AngelRam320/Rosetta_Base_v0.1/Core/Src/main.c

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
/* Includes ------------------------------------------------------------------*/
#include "main.h"
#include "fatfs.h"
#include "i2c.h"
#include "rtc.h"
#include "spi.h"
#include "tim.h"
#include "gpio.h"

/* USER CODE BEGIN Includes */
#include "rosetta.h"
#include "sdio.h"
/* USER CODE END Includes */


void SystemClock_Config(void);
/**
  * @brief  The application entry point.
  * @retval int
  */
int main(void)
{

  /* MCU Configuration--------------------------------------------------------*/

  /* Reset of all peripherals, Initializes the Flash interface and the Systick. */
  HAL_Init();

  /* Configure the system clock */
  SystemClock_Config();

  /* Initialize all configured peripherals */
  MX_GPIO_Init();
  MX_I2C1_Init();
  MX_RTC_Init();
  MX_SPI3_Init();
  MX_TIM12_Init();
  MX_FATFS_Init();
  /* USER CODE BEGIN 2 */
  RosettaHandles rosetta_hw =
  {
    .i2c_internal   = &hi2c1,
    .spi_flash      = &hspi3,
    .rtc            = &hrtc,
    .sd             = &hsd,
    .buzzer_tim     = &htim12,
    .buzzer_channel = TIM_CHANNEL_1
  };

  Rosetta_Init(&rosetta_hw);
  /* USER CODE END 2 */

  /* Infinite loop */
  /* USER CODE BEGIN WHILE */
  while (1)
  {
    Rosetta_Update();
    /* USER CODE END WHILE */

    /* USER CODE BEGIN 3 */
  }
  /* USER CODE END 3 */
}

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
