AngelRam320/Rosetta_Base_v0.1/Rosetta_Base.ioc

Mcu.UserName=STM32F446RETx
PA13.Signal=SYS_JTMS-SWDIO
PA14.Signal=SYS_JTCK-SWCLK
PA15.GPIO_Label=USER_LED
PA15.Signal=GPIO_Output
PB0.Signal=SDIO_D1
PB1.Signal=SDIO_D2
PB14.Signal=S_TIM12_CH1
PB15.GPIO_Label=USER_KEY
PB15.Signal=GPIO_Input
PB2.Signal=SDIO_CK
PB3.Signal=SPI3_SCK
PB4.Signal=SPI3_MISO
PB5.GPIO_Label=FLASH_CS
PB5.Signal=GPIO_Output
PB6.Signal=I2C1_SCL
PB7.Signal=I2C1_SDA
PC1.Signal=SPI3_MOSI
PC11.Signal=SDIO_D3
PC14-OSC32_IN.Signal=RCC_OSC32_IN
PC15-OSC32_OUT.Signal=RCC_OSC32_OUT
PC8.Signal=SDIO_D0
PD2.Signal=SDIO_CMD
PH0-OSC_IN.Signal=RCC_OSC_IN
PH1-OSC_OUT.Signal=RCC_OSC_OUT
