AngelRam320/Rosetta_Base_v0.1/Core/Inc/main.h

#define USER_KEY_Pin GPIO_PIN_15
#define USER_KEY_GPIO_Port GPIOB
#define USER_LED_Pin GPIO_PIN_15
#define USER_LED_GPIO_Port GPIOA
#define FLASH_CS_Pin GPIO_PIN_5
#define FLASH_CS_GPIO_Port GPIOB
