AngelRam320/Rosetta_Base_v0.1/Rosetta/Inc/rosetta_logo.h

#ifndef ROSETTA_LOGO_H
#define ROSETTA_LOGO_H
#include <stdint.h>
#define ROSETTA_LOGO_WIDTH 128
#define ROSETTA_LOGO_HEIGHT 64
static const uint8_t rosetta_logo_128x64[1024] = {
    0xFF, 0xFF, 0xFF, 0xFF, 0xFF, 0xFF, 0xFF, 0xFF, 0xFF, 0xFF, 0xFF, 0xFF, 0xFF, 0xFF, 0xFF, 0x01,
    0x01, 0xF1, 0xF1, 0xF1, 0xF1, 0xF1, 0xF1, 0xF1, 0xF1, 0xF3, 0x03, 0x07, 0xFF, 0xFF, 0x1F, 0x07,
    0xC3, 0xF3, 0xF3, 0xF1, 0xF1, 0xF1, 0xF1, 0xF1, 0xF3, 0xF3, 0xC3, 0x07, 0x1F, 0xFF, 0xFF, 0x87,
    0x03, 0x33, 0x71, 0x71, 0x71, 0x71, 0x71, 0x71, 0x71, 0x71, 0x71, 0xFB, 0xFF, 0xFF, 0x03, 0x01,
    0xF1, 0xF1, 0x71, 0x71, 0x71, 0x71, 0x71, 0x71, 0x71, 0xFF, 0xFF, 0xF1, 0xF1, 0xF1, 0xF1, 0x01,
    0x01, 0x01, 0xF1, 0xF1, 0xF1, 0xF1, 0xFF, 0xFF, 0xF1, 0xF1, 0xF1, 0xF1, 0x01, 0x01, 0x01, 0xF1,
    0xF1, 0xF1, 0xF1, 0xFF, 0xFF, 0xFF, 0x3F, 0x0F, 0x87, 0xE1, 0xE1, 0x87, 0x1F, 0x3F, 0xFF, 0xFF,
    0xFF, 0xFF, 0xFF, 0xFF, 0xFF, 0xFF, 0xFF, 0xFF, 0xFF, 0xFF, 0xFF, 0xFF, 0xFF, 0xFF, 0xFF, 0xFF,
    0xFF, 0xFF, 0xFF, 0xFF, 0xFF, 0xFF, 0xFF, 0xFF, 0xFF, 0xFF, 0xFF, 0xFF, 0xFF, 0xFF, 0xFF, 0xC0,
    0xC0, 0xFF, 0xFD, 0xF9, 0xFD, 0xFD, 0xFD, 0xF9, 0xF0, 0xE0, 0xC4, 0xCE, 0xDF, 0xFF, 0xFC, 0xF0,
    0xE3, 0xC7, 0xCF, 0xCF, 0xCF, 0xCF, 0xCF, 0xCF, 0xCF, 0xC7, 0xE3, 0xF0, 0xF8, 0xFF, 0xFF, 0xCF,
    0xCF, 0xCF, 0xCF, 0xCF, 0xCF, 0xCF, 0xCF, 0xCF, 0xCE, 0xC6, 0xC0, 0xE0, 0xFF, 0xFF, 0xC0, 0xC0,
    0xC7, 0xCF, 0xCF, 0xCF, 0xCF, 0xCF, 0xCF, 0xCF, 0xCF, 0xFF, 0xFF, 0xFF, 0xFF, 0xFF, 0xFF, 0xC0,
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
    0xFF, 0xFF, 0xFF, 0xFF, 0xFF, 0xFF, 0xFF, 0xFF, 0xFF, 0xFF, 0xFF, 0xFF, 0xFF, 0xFF, 0xFF, 0xFF,
    0xFF, 0xFF, 0xFF, 0xFF, 0xFF, 0xFF, 0xFF, 0xFF, 0xFF, 0xFF, 0xFF, 0xFF, 0xFF, 0xFF, 0xFF, 0xFF,
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
};
#endif
