AngelRam320/Rosetta_Base_v0.1/Rosetta/Inc/rosetta_font5x7.h

#ifndef ROSETTA_FONT5X7_H
#define ROSETTA_FONT5X7_H
#include <stdint.h>
#define ROSETTA_FONT_FIRST 32
#define ROSETTA_FONT_LAST 95
static const uint8_t rosetta_font5x7[64][5] = {
    {0x00, 0x00, 0x00, 0x00, 0x00}, /* ' ' */
    {0x00, 0x00, 0x5F, 0x00, 0x00}, /* '!' */
    {0x00, 0x03, 0x00, 0x03, 0x00}, /* '"' */
    {0x12, 0x3F, 0x12, 0x3F, 0x12}, /* '#' */
    {0x24, 0x2A, 0x7F, 0x2A, 0x12}, /* '$' */
    {0x13, 0x0B, 0x34, 0x32, 0x01}, /* '%' */
    {0x36, 0x49, 0x55, 0x22, 0x50}, /* '&' */
    {0x00, 0x00, 0x03, 0x00, 0x00}, /* '\'' */
    {0x00, 0x1C, 0x22, 0x41, 0x00}, /* '(' */
    {0x00, 0x41, 0x22, 0x1C, 0x00}, /* ')' */
    {0x2A, 0x1C, 0x3E, 0x1C, 0x2A}, /* '*' */
    {0x08, 0x08, 0x3E, 0x08, 0x08}, /* '+' */
    {0x00, 0x40, 0x30, 0x00, 0x00}, /* ',' */
    {0x08, 0x08, 0x08, 0x08, 0x08}, /* '-' */
    {0x00, 0x00, 0x60, 0x60, 0x00}, /* '.' */
    {0x10, 0x08, 0x04, 0x02, 0x01}, /* '/' */
    {0x3E, 0x51, 0x49, 0x45, 0x3E}, /* '0' */
    {0x00, 0x42, 0x7F, 0x40, 0x00}, /* '1' */
    {0x42, 0x61, 0x51, 0x49, 0x46}, /* '2' */
    {0x41, 0x49, 0x49, 0x49, 0x36}, /* '3' */
    {0x18, 0x14, 0x12, 0x7F, 0x10}, /* '4' */
    {0x4F, 0x49, 0x49, 0x49, 0x31}, /* '5' */
    {0x3E, 0x49, 0x49, 0x49, 0x30}, /* '6' */
    {0x01, 0x71, 0x09, 0x05, 0x03}, /* '7' */
    {0x36, 0x49, 0x49, 0x49, 0x36}, /* '8' */
    {0x06, 0x49, 0x49, 0x49, 0x3E}, /* '9' */
    {0x00, 0x00, 0x36, 0x36, 0x00}, /* ':' */
    {0x00, 0x40, 0x36, 0x16, 0x00}, /* ';' */
    {0x08, 0x14, 0x22, 0x41, 0x00}, /* '<' */
    {0x14, 0x14, 0x14, 0x14, 0x14}, /* '=' */
    {0x00, 0x41, 0x22, 0x14, 0x08}, /* '>' */
    {0x02, 0x01, 0x51, 0x09, 0x06}, /* '?' */
    {0x3E, 0x41, 0x5D, 0x55, 0x1E}, /* '@' */
    {0x7E, 0x09, 0x09, 0x09, 0x7E}, /* 'A' */
    {0x7F, 0x49, 0x49, 0x49, 0x36}, /* 'B' */
    {0x3E, 0x41, 0x41, 0x41, 0x41}, /* 'C' */
    {0x7F, 0x41, 0x41, 0x41, 0x3E}, /* 'D' */
    {0x7F, 0x49, 0x49, 0x49, 0x41}, /* 'E' */
    {0x7F, 0x09, 0x09, 0x09, 0x01}, /* 'F' */
    {0x3E, 0x41, 0x49, 0x49, 0x79}, /* 'G' */
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
};
#endif
