AngelRam320/Rosetta_Base_v0.1/Rosetta/Inc/rosetta_status.h

#ifndef ROSETTA_STATUS_H
#define ROSETTA_STATUS_H

#include <stdint.h>

typedef enum
{
    ROSETTA_TEST_UNKNOWN = 0,
    ROSETTA_TEST_PASS,
    ROSETTA_TEST_FAIL,
    ROSETTA_TEST_UNTESTED
} RosettaTestState;

typedef struct
{
    RosettaTestState hse;
    RosettaTestState lse;
    RosettaTestState oled;
    RosettaTestState ina260;
    RosettaTestState eeprom;
    RosettaTestState flash;
    RosettaTestState rtc;
    RosettaTestState sd;

    uint8_t oled_addr7;
    uint8_t ina260_addr7;
    uint8_t eeprom_addr7;
    uint32_t flash_jedec_id;

    uint8_t sd_card_present;
    uint8_t sd_sdio_ok;
    uint8_t sd_fatfs_ok;
    uint8_t sd_rw_ok;
    uint32_t sd_size_mb;
    uint8_t sd_fatfs_result;

    float bus_voltage_v;
    float current_ma;
    float power_mw;

    uint32_t sysclk_hz;
    uint32_t hclk_hz;
    uint32_t pclk1_hz;
    uint32_t pclk2_hz;

    uint8_t rtc_hours;
    uint8_t rtc_minutes;
    uint8_t rtc_seconds;
    uint8_t rtc_date;
    uint8_t rtc_month;
    uint8_t rtc_year;

    uint8_t overall_pass;
} RosettaBoardStatus;

#endif
